TheRealNightmare/PlayerKoi/docs/gifs/king.gif

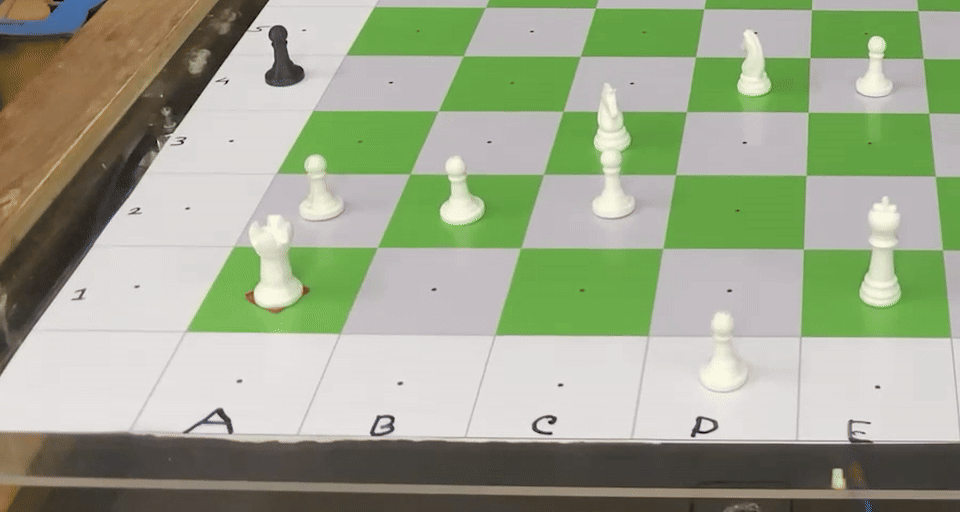
docs/gifs/king.gif
