TheRealNightmare/PlayerKoi/docs/gifs/queen.gif

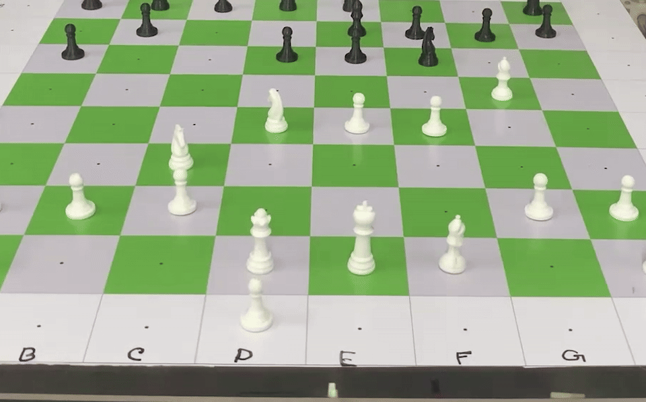
docs/gifs/queen.gif
