TheRealNightmare/PlayerKoi/RUNBOOK.md

# Runbook

Copy-pasteable command sequences for everything you actually do. Every command
here is executable as written — no placeholders to substitute.

- Whole cycle explained start to finish → [WORKFLOW.md](WORKFLOW.md)
- *Why* it works this way → [README.md](README.md) and [training/NOTES.md](training/NOTES.md)

## What do you want to do?

| | Section |
|---|---|
| Move data or models between the Pi and the PC | [A](#a-moving-files-between-the-machines) |
| Train a model — fresh, or improve the existing one | [B](#b-training) |
| Collect data for a new room / board / lighting | [C](#c-collect-data-for-an-environment) |
| Use crops collected automatically while playing | [D](#d-harvest-from-play) |
| Put a trained model on the Pi | [E](#e-export-and-deploy) |
| Play against the engine | [F](#f-playing-against-the-engine) |
| Play against the robot arm | [G](#g-playing-with-the-robot-arm) |
| Reprint the board sticker, or re-cut the panel | [J](#j-the-board-itself) |
| Watch the machine play itself | [G2](#g2-ai-vs-ai-no-camera) |
| Just start it and pick a mode | [G0](#g0-the-player-koi-menu) |
| Something broke | [H](#h-gotchas-that-have-actually-bitten) · [I](#i-tuning-knobs) |

## Machines

| | Path | venv |
|---|---|---|
| **Pi** (`nightmare@192.168.0.106`) | `~/C/PlayerKoi` | `.venv` |
| **Training PC** | `~/MicroChess` | `.venv-train` |

```bash
# Pi
ssh nightmare@192.168.0.106
cd ~/C/PlayerKoi && source .venv/bin/activate

# Training PC
cd ~/MicroChess && source .venv-train/bin/activate
```

The camera is on the Pi, so **all data is collected there**. The GPU is on the
PC, so **all training happens there**. Section A is how things cross.

## How the scripts find your model

`export_ncnn.py`, `eval_by_env.py` and `deploy.py` all resolve weights the
same way, so you normally pass **no path at all**:

```bash
ls runs/classify/*/weights/best.pt     # what you actually have
```

- **No flag** → the newest run under `runs/classify/`, printed for you to
  confirm. Add `--yes` to skip the prompt (needed in scripts — without a
  terminal it refuses rather than hanging).
- **`--run NAME`** → a specific run, e.g. `--run train-2`. Use this to go back
  to an older model.
- **A full path** (`--weights ...` / `--model-dir ...`) → always wins.

Ultralytics auto-increments run names (`train` → `train-2` → `train-3`), which
is why nothing below hardcodes one. Pass a path that doesn't exist and the
error lists the runs you really have.

> ⚠️ `runs/`, `training/datasets/` and `*.pt` are **git-ignored**. A trained
> `best.pt` exists in exactly one place — this machine's disk. Clearing
> `runs/` destroys it permanently; NCNN on the Pi cannot be converted back.
> The dataset is what's truly irreplaceable, so keep it on both boxes.

---

## A. Moving files between the machines

Everything moves by `rsync` over ssh. **Trailing slashes on both sides are
required** — they mean "the contents of", and without them you get a nested
directory. `rsync` **merges** into the destination; it never wipes what's
already there.

| What | Direction | When |
|---|---|---|
| `training/datasets/squares/` | Pi → PC | after collecting ([C](#c-collect-data-for-an-environment)) |
| `training/datasets/harvested/` | Pi → PC | after playing with `--harvest` ([D](#d-harvest-from-play)) |
| NCNN model directory | PC → Pi | after training ([E](#e-export-and-deploy)) |
| `config/calibration-env*.json` | **stays on the Pi** | never moves — it describes that Pi's camera |

### Pull the dataset (Pi → PC)

```bash
# on the training PC
rsync -av nightmare@192.168.0.106:~/C/PlayerKoi/training/datasets/squares/ \
          training/datasets/squares/
```

Verify it arrived before training on it:

```bash
find training/datasets/squares -name "*.jpg" \
  | sed 's#.*/\([^/]*\)/[^/]*$#\1#' | sort | uniq -c

tail -1 training/datasets/squares/manifest.jsonl
```

### Pull harvested crops (Pi → PC)

```bash
rsync -av nightmare@192.168.0.106:~/C/PlayerKoi/training/datasets/harvested/ \
          training/datasets/harvested/
```

Keep this **separate** from `squares/` until you've inspected it — see
[section D](#d-harvest-from-play).

### Push the model (PC → Pi)

Covered in full by [section E](#e-export-and-deploy) — `deploy.py` wraps the
`scp`, and the old model must be deleted first.

### Move everything at once

After a collecting session, before a training session:

```bash
# PC: pull both datasets
rsync -av nightmare@192.168.0.106:~/C/PlayerKoi/training/datasets/squares/ \
          training/datasets/squares/
rsync -av nightmare@192.168.0.106:~/C/PlayerKoi/training/datasets/harvested/ \
          training/datasets/harvested/
```

Going the other way — a fresh Pi, or one whose dataset you cleared — push the
dataset back so both machines hold a copy:

```bash
rsync -av training/datasets/squares/ \
          nightmare@192.168.0.106:~/C/PlayerKoi/training/datasets/squares/
```

Add `--dry-run` to any of these to see what would transfer without doing it.

---

## B. Training

**Nothing here ever trains from scratch.** Both modes below start from a
pretrained model — the only question is *which* pretrained model:

| Mode | Starts from | Use when |
|---|---|---|
| **Fresh** | `yolov8n-cls.pt` (ImageNet) | no previous run on this machine; or the current model went bad and you want a clean slate |
| **Continue** | your own `best.pt` | you added data and want to keep what the model already learned |

### Fresh — start from the pretrained YOLOv8n-cls

```bash
python training/train_classifier.py --data training/datasets/squares
```

That's the whole command. `--model` defaults to `yolov8n-cls.pt`, which
ultralytics downloads automatically if it isn't in the repo root.

Use this when `ls runs/classify/*/weights/best.pt` comes back empty, or when
you want to rule out a bad previous model. It costs ~30 s on the GPU for a
12-round dataset, so a clean rerun is cheap.

### Continue — fine-tune your current best

```bash
python training/train_classifier.py --data training/datasets/squares \
    --model runs/classify/train/weights/best.pt
```

This is the normal path after adding an environment or merging harvested
crops: it keeps everything the model learned about your *other* environments
instead of relearning them. Point `--model` at a path that exists — unlike the
other scripts, this flag is not auto-resolved, and a wrong path is an error
rather than a fallback.

### Resume an interrupted run

```bash
python training/train_classifier.py --resume --name train
```

Picks up from `runs/classify/<name>/weights/last.pt`. Only works once the run
has saved at least one epoch; data/epochs/imgsz come from the checkpoint, so
don't re-pass them.

### Flags worth knowing

| Flag | Default | Why you'd change it |
|---|---|---|
| `--epochs` | 50 | More rarely helps — collect data instead |
| `--imgsz` | 64 | **Keep in sync with `src/square_classifier.py`** |
| `--batch` | -1 (auto) | Auto-sizes to VRAM |
| `--device` | 0 | `cpu` to force CPU |
| `--name` | train | Label a run: `--name env3-test` |
| `--workers` | 8 | Lower to 2 or 0 on WSL2 |
| `--allow-cpu` | off | Otherwise it aborts rather than crawling on CPU |

### Reading the result

```
                   all      0.984          1     <- val top-1, per epoch
Test top-1: 0.9648   top-5: 1.0000              <- the honest number
Done. Best weights: .../runs/classify/train/weights/best.pt
```

**Trust the test number.** `best.pt` is chosen by whichever epoch scored best
on `val/`, so val has been peeked at. Then break it down per environment:

```bash
python training/eval_by_env.py --data training/datasets/squares
```

A weak row means collect more rounds *in that environment*. An old row that
dropped means the model is trading environments against each other — that one
needs more rounds too.

Then [export and deploy](#e-export-and-deploy).

---

## C. Collect data for an environment

An **environment** is one combination of room, lighting, camera height, board
and piece set. The classifier sees the board surface as background, so a
different board is a different problem — and so is a big lighting or
camera-position change. Run this section once per environment, with a new
`--env` tag each time.

**0. Probe first — does it even need training?**

Don't spend 25 rounds on a hunch. Calibrate, then point the *current* model at
the new setup and look at the grid:

```bash
# on the Pi
python3 src/calibrate.py --env 3
python3 src/debug_classifier.py --calibration config/calibration-env3.json
```

Any square showing the **wrong colour**, or more than ~15 of 64 below
min-conf, means train for it. If it looks clean, get a real number from 4
throwaway rounds:

```bash
# Pi
python3 src/collect_square_crops.py --env 3 --rounds 4 \
    --out training/datasets/probe-env3 --notes "PROBE"

# training PC
rsync -av nightmare@192.168.0.106:~/C/PlayerKoi/training/datasets/probe-env3/ \
          training/datasets/probe-env3/
python training/eval_by_env.py --data training/datasets/probe-env3 --split train
```

≥99% → no training needed, just play. 97–99% → 10–12 rounds. <97% → the full
25–30. Full procedure and how to read the confusions:
[WORKFLOW.md § 9](WORKFLOW.md#9-testing-a-new-environment-before-training).

If you do train, fold the probe in rather than recollecting it — it's already
labelled and already tagged `env3-`:

```bash
rsync -av training/datasets/probe-env3/ training/datasets/squares/
rm -rf training/datasets/probe-env3
```

**1. Collect** (on the Pi) — set the board up physically first

```bash
python3 src/collect_square_crops.py --env 3 --rounds 20 \
    --notes "spare room, ceiling light, glass set"
```

The env prefix keeps this run from overwriting earlier ones, so it **adds** to
the dataset. It prints existing counts on startup — confirm it's growing — and
appends a line to `training/datasets/squares/manifest.jsonl`.

Rounds are split whole into `train/` / `val/` / `test/`; never re-split these
by file, or burst frames leak across splits and the accuracy becomes a lie.

Collection doesn't use the model at all, only calibration, so it's fine that
the current model is useless in the new environment.

How much: **12 rounds** is the minimum (~97–98%, frequent corrections),
**25–30** is the target (~99%+). Split across sittings — 15 in daylight plus
15 under lamplight beats 30 in one go. The maths:
[WORKFLOW.md § 3c](WORKFLOW.md#3c-how-much-data-do-i-need).

**2. Move it to the PC** — [section A](#a-moving-files-between-the-machines).

**3. Train** — [section B](#b-training), *continue* mode if you already have a
model, *fresh* if you don't.

**4. Deploy** — [section E](#e-export-and-deploy).

> More rounds mainly buys **per-square coverage** (~10 of 64 squares get a
> piece per round). But 30 rounds in one sitting is one lighting condition —
> 15 now and 15 this evening is worth more.

---

## D. Harvest from play

`web_ui.py --harvest` saves labelled crops for all 64 squares every time a
move resolves — the tracker knows the true board state at that moment, so the
labels come free. It only writes crops; **nothing improves until you merge and
retrain.**

**1. Pull the crops** — [section A](#a-moving-files-between-the-machines)

```bash
rsync -av nightmare@192.168.0.106:~/C/PlayerKoi/training/datasets/harvested/ \
          training/datasets/harvested/
```

**2. Inspect before trusting it**

```bash
find training/datasets/harvested -name "*.jpg" \
  | sed 's#.*/\([^/]*\)/[^/]*$#\1#' | sort | uniq -c

ls training/datasets/harvested/train/black | head
```

These labels came from the tracker, not from you. If it was misreading a
square, merging teaches it its own mistake. Harvest is also excluded on undo,
deliberately — an undo reports the reverted position while the physical board
still shows the post-move one.

**3. Back up, then merge**

```bash
cp -r training/datasets/squares training/datasets/squares.bak
rsync -av training/datasets/harvested/ training/datasets/squares/
```

**4. Fine-tune** — *continue* mode, [section B](#b-training)

```bash
python training/train_classifier.py --data training/datasets/squares \
    --model runs/classify/train/weights/best.pt
```

**5. Check it didn't get worse**

```bash
python training/eval_by_env.py --data training/datasets/squares
```

**6. Export and deploy** — [section E](#e-export-and-deploy).

**7. If accuracy dropped**, the harvested labels were noisy:

```bash
rm -rf training/datasets/squares
mv training/datasets/squares.bak training/datasets/squares
# then redeploy the previous model with --run <older run>
```

Once a batch is merged and working, clear the Pi's copy so the next pull only
brings new material:

```bash
ssh nightmare@192.168.0.106 'rm -rf ~/C/PlayerKoi/training/datasets/harvested'
```

---

## E. Export and deploy

```bash
python training/export_ncnn.py --imgsz 64

mv runs/classify/train/weights/best_ncnn_model \
   runs/classify/train/weights/square_classifier_ncnn_model

# delete the old model FIRST — see gotchas
ssh nightmare@192.168.0.106 'rm -rf ~/C/PlayerKoi/models/square_classifier_ncnn_model'

python training/deploy.py nightmare@192.168.0.106 --dest ~/C/PlayerKoi/models/
```

Both scripts default to the newest run; add `--run train-2` to ship an older
one (that's also how you roll back). The `mv` gives the directory the name
`src/main.py`, `web_ui.py` and `debug_classifier.py` all expect.

Then on the Pi:

```bash
python3 src/debug_classifier.py      # verify before trusting it
python3 src/web_ui.py --harvest
```

Open `http://192.168.0.106:8000/`.

---

## F. Playing against the engine

```bash
sudo apt install stockfish           # one-time, on the Pi
python3 src/web_ui.py --harvest
```

Toggle the engine on in the box at the bottom, set the skill slider low to
start. Play your White move physically; the box shows Black's reply
(`d7 → d5`) with both squares highlighted, spelling out the extra action
for castling / en passant / promotion.

While a move is pending it's the **only** move the tracker accepts. Undo
and Edit board override that if you want to deviate.

---

## G0. The Player Koi menu

One launch, and you choose the mode in the browser:

```bash
python3 src/web_ui.py --robot /dev/ttyACM0        # or 'auto', or 'mock'
```

Park the carriage on **a8** first — it homes on startup. Then open
`http://<this-pi>:8000/` and pick a card:

| Card | What it is |
|---|---|
| **AI vs AI** | Section [G2](#g2-ai-vs-ai-no-camera) — no camera needed |
| **Play the engine** | Section [G](#g-playing-with-the-robot-arm) — needs calibration and a model |

A mode you can't run is greyed out with the reason and the script that fixes
it, so a fresh Pi with no model still gets you into AI vs AI.

The menu also sets skill, think time, move delay and the beginner style before
you start; the command-line flags become the menu's starting values.

**Back to menu** ends the mode and **parks the carriage at the origin**. The
game is discarded — re-entering a mode always starts from scratch, which
matches having to reset the pieces by hand.

**Reset** (on both screens) starts a new game *and* parks. It asks first,
because the carriage crosses the whole board to get there and will shove
anything standing in its way. On the menu it parks and nothing more.

The gantry's serial port is opened **once**, for the life of the process —
reopening it resets the Uno and loses the position — so switching modes never
costs you a re-park or a re-home.

The old direct commands still work and skip the menu:

```bash
python3 src/web_ui.py --ai-vs-ai --robot auto     # straight into AI vs AI
```

---

## G. Playing with the robot arm

Full circuit and first-time bring-up: **[docs/HARDWARE.md](docs/HARDWARE.md)**.
This section is the day-to-day sequence once it's built and calibrated.

**1. Power up in this order** — USB first, barrel jack second, with the
carriage hand-parked in the corner of travel beyond **h1** (White's right-hand
corner).

```bash
ls /dev/ttyACM*                      # confirm the Uno enumerated
```

That corner is the firmware's origin (0, 0), and since the r5 re-measurement the
firmware's square names are the real squares, so `rig.ORIGIN_SQUARE = "h1"`
sends them unrotated — `GOTO a1` from the web app and from the serial monitor
land on the same square. If the board is ever re-seated and the arm reaches for
the wrong squares, try the other corners with `--board-origin`.

The carriage has to be in that corner **every time the web app starts**, not
just at power-up: opening the serial port resets the Arduino, and it takes
wherever the carriage is standing as (0, 0). Left mid-board after a serial
monitor session, every move is offset and the edge squares run off the frame.

**2. First time on a rebuilt/re-flashed rig,** verify the geometry and the
clearance before anything touches a real game — `GOTO 7 0` must travel exactly
350 mm, and a knight must leave the back rank without catching the pawns
either side. Both procedures are in
[docs/HARDWARE.md](docs/HARDWARE.md#bring-up-and-calibration), steps 4 and 7.

Also check the arm can reach past the board edge, which is new with the V2
frame and is what captures depend on:

```
MM -415 10         # the slot past a1        → OK MM, not ERR out of range
MM -465 60         # the slot past the a-file
MM -15 410         # the slot past the h-file
BURY e2 -365 10    # carry a real pawn off — watch the set-down, not the drive
```

An `ERR out of range` here means the board is flashed with V1's travel limits.
A piece that is *towed* as the carriage leaves means the settle pause is too
short (`DWELL`); an ordinary move sets down the same way, so fix it here.

**On a frame that has never moved before**, do the walker instead of the four
commands above — it covers the same ground exhaustively and with the magnet
dead, so nothing can be dragged while you find out the frame is wrong. Flash
`firmware/chessbot_walker/chessbot_walker.ino`, open the serial monitor at
115200, press `5` to prove the travel limits, `1` for the four corners, then `3` for the graveyard ring, then
`2` for all 64 squares. Each stop should land on its printed dot.
**Re-flash `chessbot_v1.ino` before connecting the Pi** — a board left with
the walker on it looks like a dead serial link.
See [docs/CONNECTION.md](docs/CONNECTION.md) for the full key list.

**3. Dry run if anything changed** (firmware, wiring, the code):

```bash
python3 src/web_ui.py --robot mock   # logs every gantry command, moves nothing
```

**4. Then for real.** It homes on startup — keep hands clear.

```bash
python3 src/web_ui.py --robot /dev/ttyACM0 --harvest
```

Toggle the engine on as usual. From then on it plays its own moves: you move
White, the arm answers.

**When it captures**, it carries the piece off the board itself: the victim
is lifted first, driven to the nearest free slot in the 50mm margin around
the board, and set down there. Nothing is asked of you. The 32 slots are
shared between both colours, so the pile is not a scoreboard — the arm takes
whichever is nearest, to keep the trip short.

The only time a capture stops is if all 32 slots are full, which cannot
happen in a legal game (30 pieces can be captured) but can if a hand-built
position and a stale pile disagree. Then it falls back to asking you to lift
the piece, as it always used to.

**When it promotes**, the UI asks you to swap a queen in. Do it; the software
already thinks it's a queen.

**If it halts** (red box), the camera didn't agree with what the arm did.
Fix the physical board with **Edit board** or **Undo last move**, then press
**Home / re-enable**. It will not move again until you do.

**Every piece is held by attract**, white and black alike — their magnets are
all fitted the same way up. Each carry is: coil off, drive to the piece, coil
on + grip pause (1000 ms), carry at constant speed, coil off + a short weak
reverse pulse that clears the core + settle pause (1000 ms).
The castling rook goes around the **outside** of the board — half a square
past the back rank, between the board and the graveyard strip — so it never
passes the king or the pawns. After a captured piece is set down in the
graveyard, the arm waits an extra second before going back for the capturer.
Knight L-moves, the castling rook and graveyard trips run at the
**Gridline power** set in the Robot arm panel (100% by default, `GRID <pct>`
in the bench console). Lower it if neighbouring pieces get dragged along; it
saves itself and is reapplied on every start.

**If the arm pushes pieces away instead of picking them up**, the magnets are
the other way up. Switch **Pieces held by** to *repel* in the Robot arm panel
(or `POL 1` in the bench console). It applies to every piece, is saved to
`config/rig.json`, and is reapplied on every start.

**If a piece slides toward the carriage before it arrives**, the core is
still magnetised from the last move. Raise **Clear pulse strength** (or
time) in the Robot arm panel. If a piece that was just set down gets pushed
instead, lower it.

**If a piece is towed along after it is set down**, the core is still
magnetised when the carriage leaves. Raise **Settle pause** in the Robot arm
panel; it saves itself to `config/rig.json`. **If a piece is left behind at
the start of a drag**, raise **Grip pause** instead.

**If the UI says the firmware is out of date**, re-upload
`firmware/chessbot_v1/chessbot_v1.ino`. The arm refuses to move until you do,
and that is deliberate: a board older than r7 still holds white pieces by
repel, so every white move would shove a piece off its square, and an r9
board has no `CASTLE`. Check with the startup line — it should say
`firmware r10`.

**Bench console** for poking the gantry directly, without any chess:

```bash
python3 src/robot.py --port /dev/ttyACM0 --console
gantry> HOME
gantry> GOTO 3.5 4
gantry> POL 1           # hold every piece by repel (0 = attract, the default)
gantry> DWELL 1000 1000 # grip pause / settle pause, ms
gantry> KICK 110 20     # clearing pulse after a set-down: duty, ms (0 0 = off)
gantry> GRID 100        # gridline magnet power, % (knights, castling, graveyard)
gantry> MAG 170
gantry> OFF
```

---

## G2. AI vs AI (no camera)

Stockfish plays both sides and the arm places every move. **Nothing in this
mode uses the camera** — no calibration, no classifier, no model. The position
is tracked purely in software (`src/headless_loop.py`), which is sound only
because the arm is the sole thing touching the board.

That is the trade: there is no verification. A slipped belt, a dragged
neighbour, a piece knocked over — none of it is detected, and every move after
it is played into a position that no longer exists.

**1. Set the board up completely.** All 32 pieces, standard position, White at
the a1 end. This is assumed, never checked.

**2. Park the carriage in the corner beyond h1** by hand. No limit switches —
`HOME` drives to the assumed origin rather than finding it.

**3. Dry run first** if anything changed:

```bash
python3 src/web_ui.py --ai-vs-ai --robot mock
```

**4. Then for real.** It homes on startup — keep hands clear.

```bash
python3 src/web_ui.py --ai-vs-ai --robot /dev/ttyACM0 \
    --engine-skill 3 --move-delay 2
```

Open the UI and press **play**. `--move-delay` is the pause between moves;
keep it generous the first few games so you have time to reach **HALT**.

**It plays like a beginner on purpose.** Pawn moves are preferred, and it will
only move a knight or castle when nothing else is legal — those are the two
moves that make the arm weave along the gridlines at reduced magnet duty, which
is where pieces get dropped. Over a full game that takes knight weaves from
roughly 15% of moves to zero. Pass `--no-noob` to play normally. It costs two
engine searches per move, so budget ~2x `--engine-think`.

**Captures no longer stop for you** — the arm parks the piece on a graveyard
slot and carries straight on. See section G.

**Promotions are advisory**: swap a queen in when asked. The software already
records it as a queen either way, so the arm will keep dragging the pawn
around as one if you don't.

**Watch the first few moves.** Once the physical board and the software
diverge, nothing will tell you — that's what the camera was for.

---

## H. Gotchas that have actually bitten

**Run directory is `train-2`, not `train2`.** Ultralytics auto-increments
with a hyphen. You rarely need to type it — the scripts default to the newest
run — but `--run` and `train_classifier.py --model` both want the real name.

**`scp -r` nests into an existing directory.** If
`models/square_classifier_ncnn_model` already exists on the Pi, deploying
creates `square_classifier_ncnn_model/square_classifier_ncnn_model` and
the model fails to load. Always `rm -rf` the old one first.

**Collect with `--env`.** Filenames are prefixed with the env tag, which is
what makes a batch traceable, removable, and scoreable by
`eval_by_env.py`. Without it the crops still land safely (the session id
defaults to a timestamp, so nothing collides) but they show up forever as
`untagged` and can't be attributed to a setup.

**`--harvest` never fixes anything by itself.** It only writes crops. You
have to merge and retrain.

**`runs/` is git-ignored, and clearing it is irreversible.** A `best.pt`
lives only on the training PC's disk; the Pi has an NCNN export, which
cannot be converted back to `.pt`. This has already cost one trained model.
The dataset matters more than the weights — weights can be retrained in
seconds, 30 rounds of collection cannot.

**Fine-tuning needs weights that exist.** `--model runs/classify/.../best.pt`
fails on a machine where `runs/` is empty. Omit `--model` and it correctly
starts from the pretrained `yolov8n-cls.pt`.

**Trust test top-1, not val.** `best.pt` is chosen by whichever epoch scored
best on `val/`, so val has effectively been peeked at. A large val-test gap
means the model memorised the training rounds — collect more, don't train
longer.

---

## I. Tuning knobs

| Problem | Knob |
|---|---|
| Moves not detected at all | `web_ui.py --motion-thresh 2.0` (default 3.0). Diagnose with `debug_classifier.py --watch` |
| Too many "low-confidence" flags | `web_ui.py --min-conf 0.4` (default 0.5) |
| Wrong moves accepted | Raise `--min-conf`, or collect more data for the squares that misread |
| Engine too strong | Skill slider in the UI (0–20; 0 is genuinely beatable) |
| Board diagram wrong | **Undo last move** for one bad move; **Edit board** for a full resync |
| Arm drops pieces mid-drag | Raise `MAG_HOLD`/`MAG_EDGE` in `src/robot_moves.py` (the firmware clamps at `MAG_MAX_PWM`) |
| **Neighbouring pieces dragged along as the arm passes** | Lower `MAG_EDGE`. This was the V1 board's defining problem; on 50 mm squares the magnet's edge stops 12.5 mm short of a flanking piece's centre, so if it still happens suspect the coil or the piece bases rather than the routing — see Clearances in [docs/HARDWARE.md](docs/HARDWARE.md) |
| **A piece is towed after it is set down** | Raise the settle pause (`DWELL`, or the Settle slider) — `BURY` sets down the same way a move does, so tuning it fixes both |
| **`ERR out of range` on a capture** | The board is flashed with travel limits that stop at the board edge. Re-upload `chessbot_v1.ino`; V2 needs x `-480..0`, y `0..470` (banner `r10`) |
| **The arm skips slots that are visibly empty** | The saved pile in `config/rig.json` is stale. Reset the game from the menu, which clears it |
| **Knight catches pieces leaving the back rank** | The opening pawn wall is the one case routing can't improve on — but on 50 mm squares that is still 25 mm each side, so this should no longer happen. If it does, the coil is too strong or reaching too far: lower `MAG_EDGE` |
| Magnet coil getting hot | Lower `MAG_MAX_PWM` in the sketch, or feed the DRV8872 from a 5 V buck |
| Pieces land off-centre | Tune `PULSE_REVERSE_MS`/`PULSE_HOLD_MS` in the sketch |
| Piece knocked off the board when toppled | Only the dormant native planner topples; the live one carries captures off. Lower `TOPPLE_MS` in `chess_gantry` if you are running that |
| Arm drifts a bit further off every move | `STEPS_PER_SQUARE` should be exactly 1000 — verify `GOTO 7 0` travels 350 mm. If it does, the motors are stalling: lower `MAX_SPEED` |
| Arm too slow | `MAX_SPEED` 1500 → 2500 steps/s (75 → 125 mm/s), once the belts are tensioned |
| Motors buzz but don't turn | `MAX_SPEED` too high to start from rest (no acceleration in `MultiStepper`), or Vref too low |
| An axis homes away from its switch | Swap one coil pair on that motor — no code change |
| Not enough time to clear a captured piece | No longer applies — the arm parks captures itself. `--topple-delay` only affects the dormant native planner |
| Arm halts constantly | The camera is disagreeing with it — check `debug_classifier.py` before blaming the gantry |
| **The Uno enumerates but answers nothing** | It may still have the bring-up walker flashed. Re-upload `firmware/chessbot_v1/chessbot_v1.ino` |

Diagnostics:

```bash
python3 src/debug_classifier.py            # per-square class + confidence
python3 src/debug_classifier.py --watch    # live motion-gate scores
```

## J. The board itself

The printed sticker and the laser-cut panel are **generated**, not drawn by
hand. Regenerate rather than editing the files in `design/`:

```bash
python3 tools/make_sticker.py                 # design/chessboard_400mm_sq50mm.pdf
python3 tools/make_board.py                   # design/ChessBot_V2_board.{dxf,ai,svg,step}
python3 tools/make_board.py --thickness 6     # ...for 6 mm MDF instead of 5 mm acrylic
```

No dependencies beyond the standard library, so these run anywhere — the
repo's `.venv-train` is not needed and is in fact broken (its `pyvenv.cfg`
points at a `site-packages` under a path it no longer lives at).

**Printing the sticker.** 570 mm is wider than A3, so it needs a wide-format
or plotter print at **100% scale — "actual size", never "fit to page"**. The
sheet carries a 100 mm ruler along the bottom for exactly this: measure it
before sticking anything down. A sticker printed at 97% puts every square's
dot progressively further from where the machine believes it is, and the
error is worst at the far corners where you will notice it last.

The dots are not decoration — they are what `src/calibrate.py` asks you to
click, and what every `GOTO` addresses. There is one per square and one per
graveyard slot.

**Changing the square size** re-cuts everything downstream, so it is a
deliberate act:

```bash
python3 tools/make_sticker.py --square 28.75 --page 295 --no-graveyard   # the V1 board
```

Then `SQUARE_MM`, `A1_X_MM` and the travel limits have to change in
`firmware/chessbot_v1/chessbot_v1.ino` **and** `src/rig.py`, which mirrors it.
The firmware is the source of truth; if the two disagree, the firmware is
right and `rig.py` is stale. `tests/test_rig.py` and `tests/test_firmware_rev.py`
check the parts of that contract they can see from Python.

**The sticker colours are load-bearing.** The classifier was trained on crops
of that specific green and grey, so changing them means retraining — see
[training/NOTES.md](training/NOTES.md).
