TheRealNightmare/PlayerKoi/docs/gifs/bishop.gif

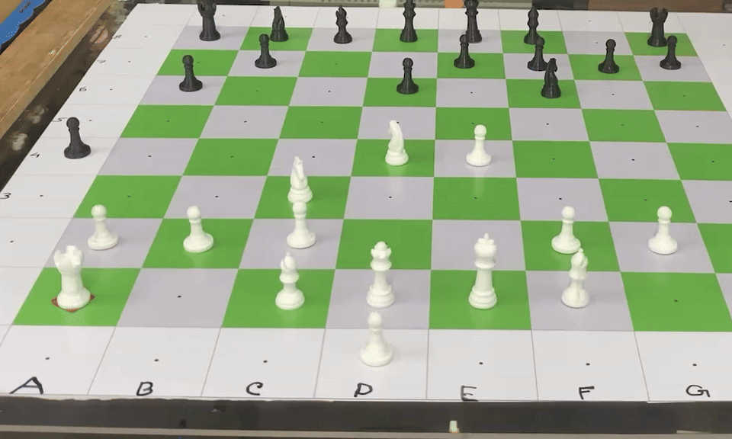
docs/gifs/bishop.gif
