TheRealNightmare/PlayerKoi/docs/gifs/capture.gif

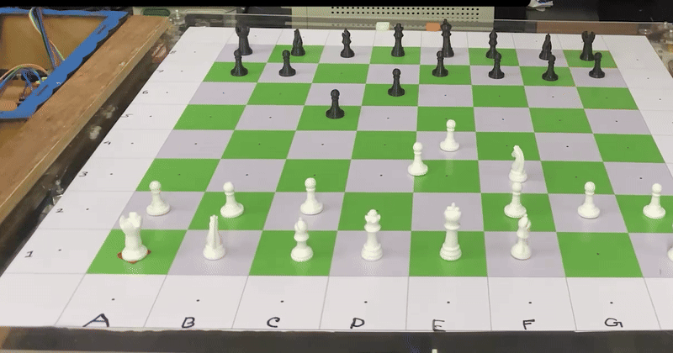
docs/gifs/capture.gif
