TheRealNightmare/PlayerKoi/docs/gifs/knight.gif

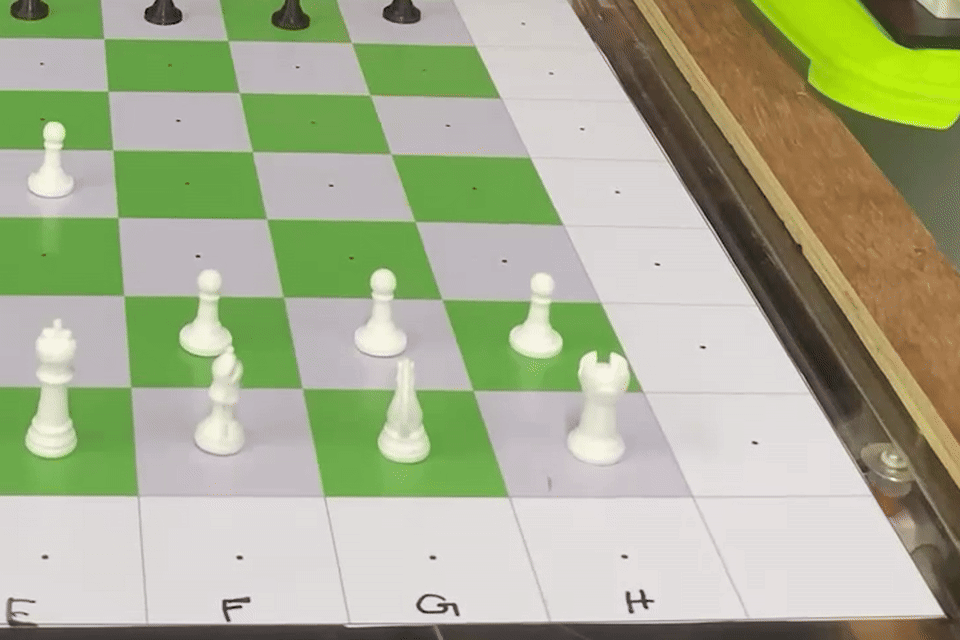
docs/gifs/knight.gif
