TheRealNightmare/PlayerKoi/docs/gifs/pawn.gif

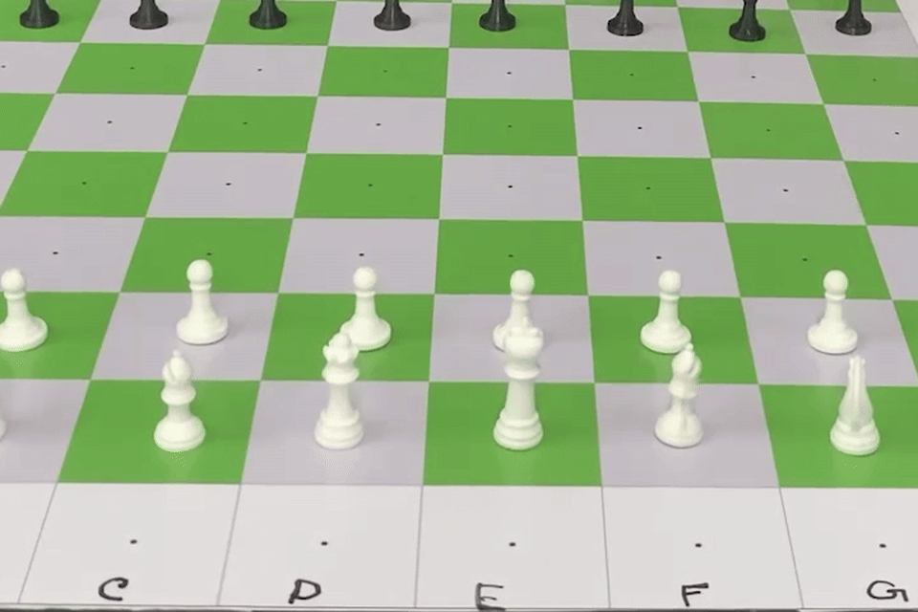
docs/gifs/pawn.gif
