TheRealNightmare/PlayerKoi/docs/gifs/rook.gif

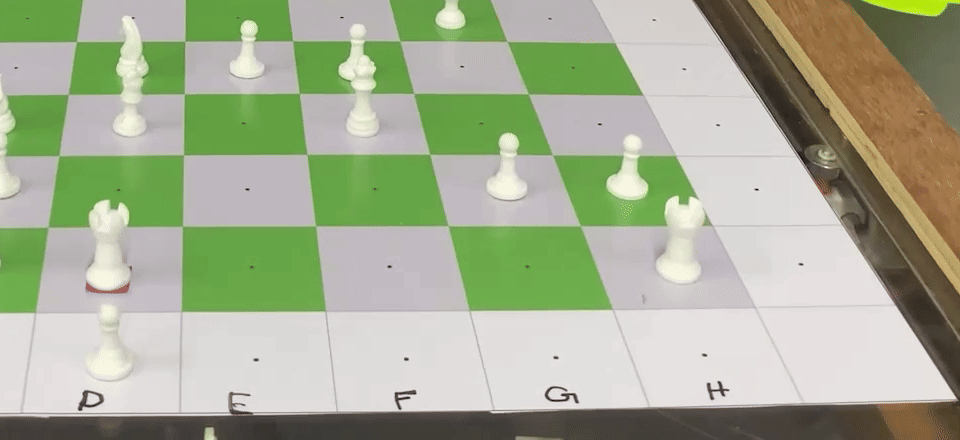
docs/gifs/rook.gif
