TheRealNightmare/PlayerKoi/video/poster.png

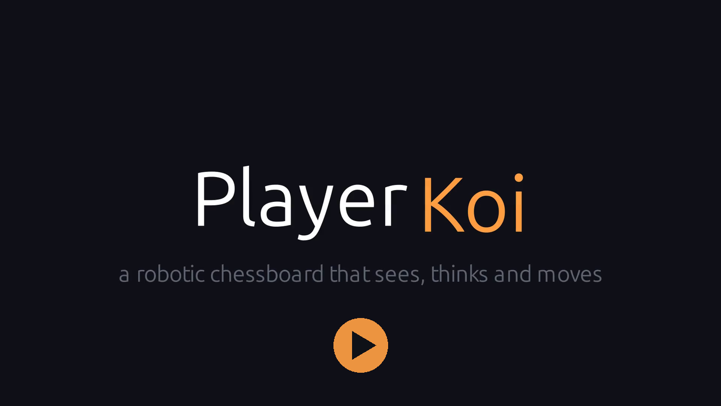
video/poster.png
