TheRealNightmare/PlayerKoi/design/ChessBot_V2_board.step

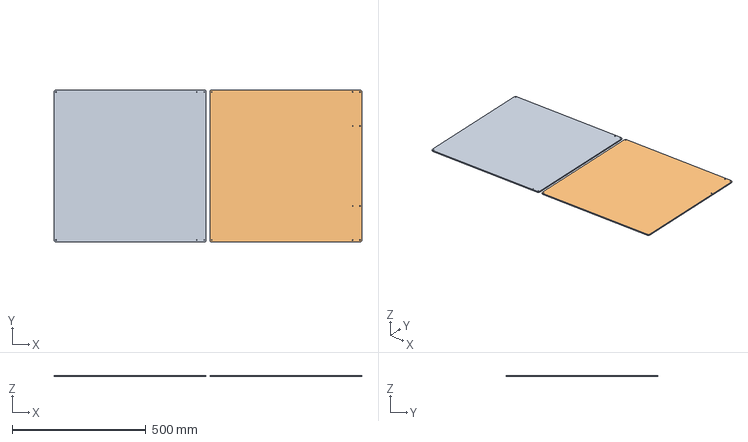
[picture p9: CAD file, 2026-09-21, last stored version]
design/ChessBot_V2_board.step
1153.6 x 570.0 x 5.00 mm
