TheRealNightmare/PlayerKoi/(list of files, cad)

Other CAD files:
design/ChessBot_V2_board.dxf
