TheRealNightmare/PlayerKoi/design/chessboard_400mm_sq50mm.pdf

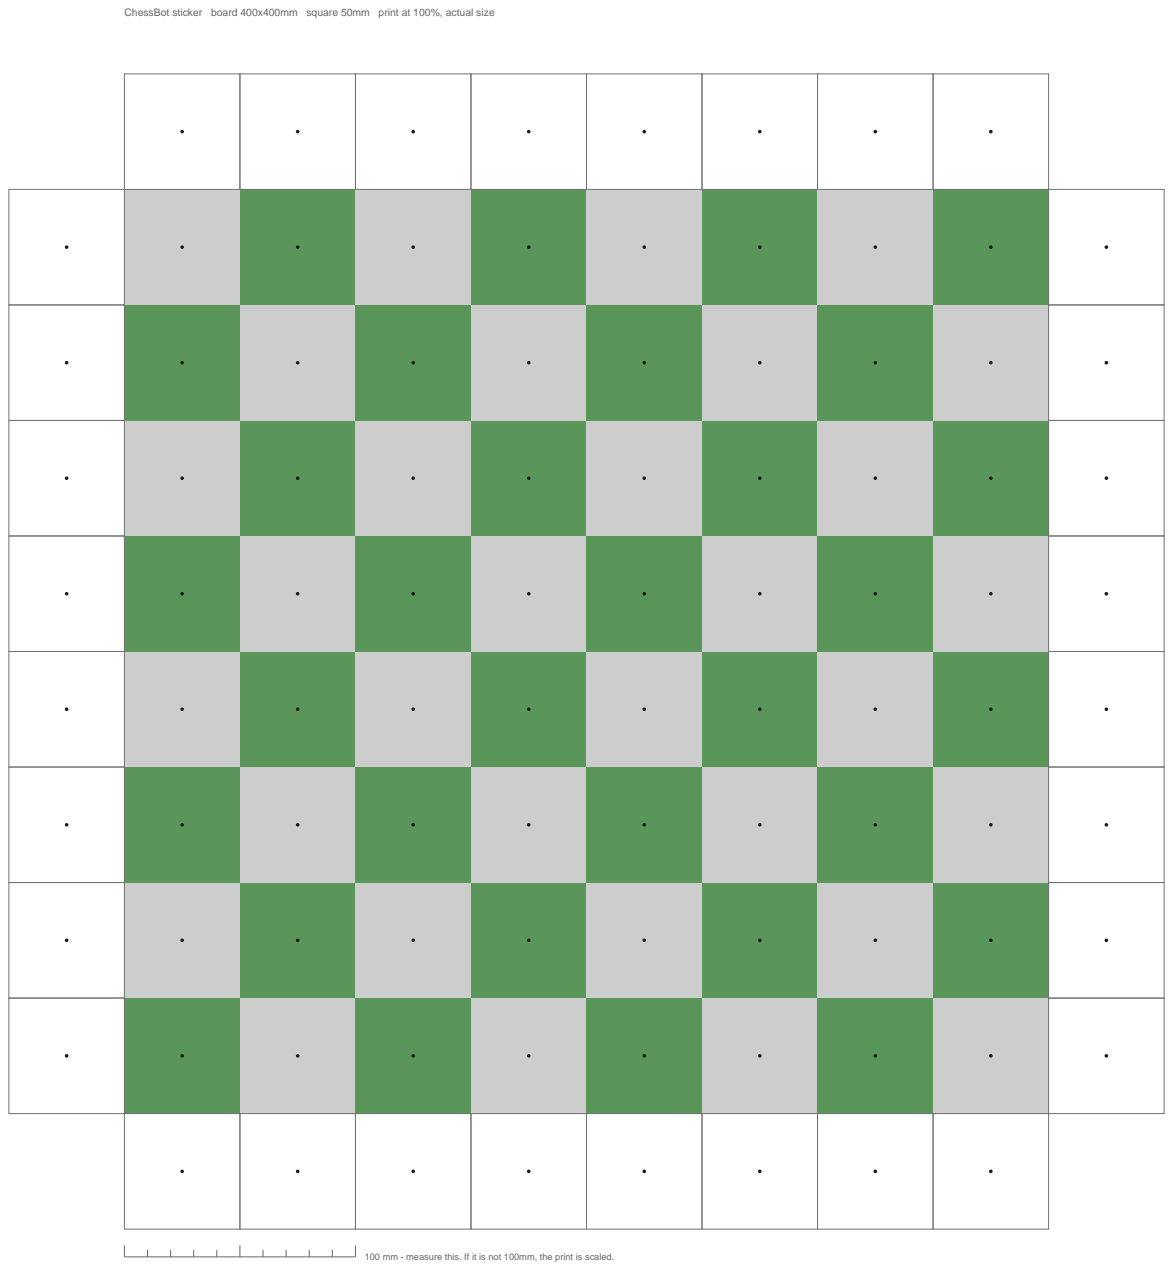
[picture p10: page 1]

ChessBot sticker board 400x400mm square 50mm print at 100%, actual size

100 mm - measure this. If it is not 100mm, the print is scaled.
