TheRealNightmare/PlayerKoi/src/rig.py

"""Measured constants for the physical machine.

Every number here was measured on the rig and is mirrored from
firmware/chessbot_v1/chessbot_v1.ino, which is the single source of truth.
This module exists so the Python side, the docs and the bench sheet can cite
one place instead of re-declaring geometry that then drifts apart.

If a value here disagrees with the firmware, the FIRMWARE is right and this
file is stale -- it is the thing that actually drives the motors.

A warning about the other numbers in this repo:

* RunChess/chess.txt has SQUARE_MM = 25.7 and a different a1 offset. That is
  an older calibration for the 200x200 frame, from before the belt slip was
  fixed by re-belting. It is superseded. Do not use it.
* firmware/chess_gantry/ declares its own constants (20 steps/mm, 75mm/s,
  MAG_MAX_PWM 170). Those belong to a different, unbuilt machine and are not
  this rig's -- see that sketch's header.

COORDINATES

Two systems meet here, so be explicit about which one is in play:

    file/rank   0..7 on each axis, a1 = (0, 0), h8 = (7, 7). What the chess
                code (robot_moves, move_resolver) speaks. Fractions are legal
                and mean the lattice line between two squares.
    machine mm  what the firmware speaks. The ORIGIN is the corner of travel
                beyond h1 (not a square centre, and not a1), and x runs
                NEGATIVE toward the a-file. So h1 is at (-65, 60) and a1 is
                at (-415, 60).

square_to_mm() converts. In legacy mode nothing on the Python side sends mm
at all -- the firmware takes square names and does its own arithmetic -- so
this conversion is for bench work and for the dormant native path.
"""

# Board geometry. V2: 400x400mm playing area on a 50mm pitch, BOTH axes -- the
# earlier 200mm Y span was belt slip and was fixed mechanically, so there is no
# separate Y pitch.
SQUARE_MM = 50.0
BOARD_MM = SQUARE_MM * 8        # 400, the playing area

# a1's centre in machine coordinates. The origin (0, 0) is the corner of
# travel beyond h1 -- as far toward the h-file and rank 1 as the carriage
# goes -- which is also the park position. So every square is at negative x
# and positive y: h1 is (-65, 60), a8 is (-415, 410).
A1_X_MM = -415.0
A1_Y_MM = 60.0

# Travel limits, MEASURED on the machine by jogging to the frame: 480 x 470mm,
# not the 500 x 500 the frame was drawn for. The graveyard ring's slot centres
# span 450mm each way, centred in that reach (15mm clear at each X limit, 10mm
# at each Y limit), and the board sits one square pitch inside the ring.
GRAVEYARD_DEPTH_MM = 50.0
MIN_X_MM, MAX_X_MM = -480.0, 0.0
MIN_Y_MM, MAX_Y_MM = 0.0, 470.0

# Where captured pieces go: a ring of parking slots in the 50mm margin, one
# strip on each of the four sides, eight slots per strip on the board's own
# file/rank centre lines. 32 in total, shared between both colours.
#
# The four 50x50mm corner cells are deliberately left empty. A corner slot
# would sit on no centre line at all, so its dot would not line up with the
# printed grid, and 32 already exceeds the 30 pieces that can ever be
# captured -- there is nothing to gain by squeezing in four more.
GRAVEYARD_Y_LOW_MM = A1_Y_MM - SQUARE_MM             # 10, beyond rank 1
GRAVEYARD_Y_HIGH_MM = A1_Y_MM + BOARD_MM             # 460, beyond rank 8
GRAVEYARD_X_LOW_MM = A1_X_MM - SQUARE_MM             # -465, beyond the a-file
GRAVEYARD_X_HIGH_MM = A1_X_MM + BOARD_MM             # -15, beyond the h-file

# Motion scale: 200 steps/rev at 1/2 microstepping over a 20-tooth GT2 pulley
# on 2mm belt = 400 steps per 40mm = 10 steps/mm. The microstepping jumpers
# matter: a CNC Shield defaults to 1/8, which would make every distance 4x
# too large. See docs/CONNECTION.md troubleshooting.
MICROSTEPS = 2
MOTOR_STEPS_PER_REV = 200.0
PULLEY_TEETH = 20.0
BELT_PITCH_MM = 2.0
MM_PER_REV = PULLEY_TEETH * BELT_PITCH_MM          # 40.0
STEPS_PER_MM = (MOTOR_STEPS_PER_REV * MICROSTEPS) / MM_PER_REV   # 10.0

# Feed rate, the proven 40mm/s. The firmware defaults to it and the host
# re-sends SPEED on every connect. The firmware accepts SPEED 1-100 mm/s.
FEED_MMS = 40.0

# Magnet duty, as a PWM count. FULL drags a piece square-to-square and is
# fixed; the gridline legs use grid_pct below. Mirrors the firmware --
# chess_gantry's 170 cap is for different hardware and does not apply.
MAG_FULL = 255

# Hand-tuned motion settings, each (default, min, max). All are runtime
# values on the board (DWELL, GRID, KICK), re-sent on every connect and adjustable
# from the web UI, because they are only judged by watching the arm:
#
#   grip_ms    coil on, carriage still, before a piece is dragged -- so it is
#              pulled flat onto the pole first. A full second: 150 ms let
#              knights slip off on the gridline run.
#   settle_ms  after the set-down and the clearing pulse, coil fully OFF,
#              before the carriage drives on. A piece still towed when the
#              carriage leaves means this is too short.
#   grid_pct   magnet power on every gridline leg (knights, the castling
#              rook, BURY), in percent of MAG_FULL. 60% and then 80% both
#              sometimes lost the piece partway along the L, hence full.
#   kick_duty  the clearing pulse after a set-down: a short, weak drive the
#   kick_ms    opposite way to the hold, to clear the leftover magnetism that
#              otherwise pulls the next piece toward the carriage before it
#              arrives. Too strong shoves the piece just set down. 0 = off.
MOTION_TUNING = {
    "grip_ms": (1000, 0, 2000),
    "settle_ms": (1000, 0, 2000),
    "grid_pct": (100, 0, 100),
    "kick_duty": (110, 0, 255),
    "kick_ms": (20, 0, 200),
}

# Every piece on this set has its magnet the same way up, so ONE polarity
# holds all of them, white and black alike. A carry is always: coil off,
# drive to the source, coil on + grip_ms, carry, coil off + settle_ms. The
# firmware owns that sequence (doMove/doKnight/doBury in chessbot_v1.ino);
# moves carry no colour.
#
# Which polarity that is: attract, as the set was magnetised. It is a runtime
# setting (POL, saved in config/rig.json, toggled in the web UI) in case the
# magnets turn out to be fitted the other way up. Mirrors HOLD_BY_REPEL in
# the sketch.
HOLD_BY_REPEL = False


# The square whose outer corner is the origin: where the carriage rests, and
# where a human must park it before HOME -- in the corner of travel beyond
# this square, not on its centre. There are no limit switches: HOME drives to
# the assumed origin rather than seeking anything, so if the carriage isn't
# actually in that corner when the board powers up, every coordinate that
# follows is silently wrong.
PARK_SQUARE = "h1"

BAUD = 115200
READY_BANNER = "READY ChessBot-V1"

# The protocol revision this code expects from the sketch. Bumped whenever the
# host starts relying on something a older board doesn't do.
#
#   r1  the original: no polarity suffix. It accepts "MOVE e2e4 w" anyway --
#       parsePly reads four characters and ignores the rest -- and silently
#       attracts for every move, which shoves every white piece off its
#       square. That silence is why this check exists.
#   r2  w|b suffix on MOVE/KNIGHT, plus POL and POLTEST.
#   r3  the faded release, plus RELEASE to tune it.
#   r4  BURY, for parking a captured piece on a graveyard slot. The first
#       command that drives to a raw machine coordinate in normal play, so an
#       r3 board cannot fake it -- it has no verb that reaches off the board.
#   r5  re-measured geometry: the origin moved from h1's centre to the corner
#       of travel beyond h1, and a1 to (-415, 60). No new verbs, but an r4
#       board takes the same square names and BURY coordinates and drives
#       somewhere else -- so it has to be refused just the same.
#   r6  DWELL (grip/settle pauses) and KICK (tunable de-cling), both sent on
#       connect, which an r5 board answers with ERR; BURY travels the
#       gridlines instead of a straight diagonal.
#   r7  every piece re-magnetised the same way up: the coil attracts all of
#       them. POL, POLTEST, RELEASE and KICK are gone, as is the w|b suffix on
#       MOVE/KNIGHT/BURY; a set-down is a plain coil-off plus the settle
#       pause. An r6 board would still hold white by repel and shove it off.
#   r8  GRID, the gridline magnet power, sent on connect -- an r7 board
#       answers ERR unknown GRID.
#   r9  KICK back: a weak reverse pulse after each set-down to clear the
#       core, sent on connect -- an r8 board answers ERR unknown KICK. Also a
#       1 s grip and settle, and constant speed (the r8 ramp is gone).
#   r10 CASTLE, the castling rook around the outside of the board, sent
#       mid-game -- an r9 board answers ERR unknown CASTLE with the king
#       already moved. Also an extra 1 s after BURY.
FIRMWARE_REV = 10

# After a captured piece is set down in the graveyard, the firmware waits
# this long on top of the settle pause. Mirrors BURY_WAIT_MS in the sketch.
BURY_WAIT_MS = 1000


def banner_rev(banner):
    """The revision from a READY line. A banner with no revision is r1 -- that
    is precisely what the original sketch prints."""
    for token in (banner or "").split():
        if token.startswith("r") and token[1:].isdigit():
            return int(token[1:])
    return 1


# ---------------------------------------------------------------- orientation
#
# The one value in this file that is NOT mirrored from the firmware, because
# the firmware has no concept of it: chessbot_v1 parses square names
# arithmetically (charAt(0) - 'a') and assumes the carriage parks beyond h1.
#
# Since the r5 re-measurement that assumption is TRUE on this machine: the
# origin, (0, 0), is the corner of travel beyond h1 -- White's right-hand
# corner -- and "GOTO a1" typed into the serial monitor lands on the real a1.
# So no correction is applied. (Before r5 the board was treated as seated
# 180 degrees round and this was "a8"; keeping that after the re-measurement
# rotated every square twice over, sending a1 past a8 into the graveyard.)
#
# The rotation is kept, and selectable with --board-origin, for a board that
# is ever re-seated. The four values are the real square the carriage parks
# beyond:
#
#     "h1"   what the firmware assumes -- no correction    <- this rig
#     "a8"   rotated 180 degrees: file AND rank flip
#     "h8"   ranks flip, files don't (a mirror, from a reversed Y axis)
#     "a1"   files flip, ranks don't
ORIGIN_SQUARE = "h1"

# (flip_file, flip_rank) for each supported origin.
_ORIENTATIONS = {
    "h1": (False, False),
    "a8": (True, True),
    "h8": (False, True),
    "a1": (True, False),
}

SUPPORTED_ORIGINS = tuple(_ORIENTATIONS)


def orient(file_, rank, origin=None):
    """(file, rank) as chess means it -> (file, rank) as the machine means it.

    Its own inverse for every supported origin, so a round trip is the
    identity and the helper can be used in either direction.
    """
    origin = ORIGIN_SQUARE if origin is None else origin
    try:
        flip_file, flip_rank = _ORIENTATIONS[origin]
    except KeyError:
        raise ValueError(
            f"unknown board origin {origin!r} -- expected one of {', '.join(_ORIENTATIONS)}"
        )
    return (7 - file_ if flip_file else file_, 7 - rank if flip_rank else rank)


def orient_square(name, origin=None):
    """"e2" -> "d7" with origin "a8"; unchanged at the default "h1". For
    square names bound for the firmware."""
    file_, rank = orient(ord(name[0]) - ord("a"), int(name[1]) - 1, origin)
    return f"{chr(ord('a') + file_)}{rank + 1}"


def orient_uci(uci, origin=None):
    """"e2e4" -> "d7d5". Only the four square characters -- a promotion
    suffix is dropped, since MOVE/KNIGHT take squares and the firmware has no
    idea what a promotion is."""
    return orient_square(uci[:2], origin) + orient_square(uci[2:4], origin)


def square_to_mm(file_, rank):
    """(file, rank) in 0..7 -> (x, y) in machine mm. Fractions are fine.

    Mirrors gotoSquareF() in the firmware.
    """
    return (A1_X_MM + file_ * SQUARE_MM, A1_Y_MM + rank * SQUARE_MM)


# The board's centre in board-space mm -- the point every orientation flip is
# symmetric about. a1 and h8 centres are 7 squares apart, so the middle is 3.5.
BOARD_CENTRE_X_MM = A1_X_MM + 3.5 * SQUARE_MM
BOARD_CENTRE_Y_MM = A1_Y_MM + 3.5 * SQUARE_MM


def orient_mm(x_mm, y_mm, origin=None):
    """Board-space mm -> machine mm, applying how the board is seated.

    The mm counterpart of orient(). It exists because orient() can only rotate
    file/rank indices, and a graveyard slot has neither -- it sits outside the
    8x8, so there is no index to flip. Reflecting the millimetres about the
    board centre does the same job and works for any point, on the board or
    off it.

    It is the identity at the default origin (h1). On a re-seated board it is
    NOT optional: with a 180 degree rotation, a slot handed to the firmware
    unmirrored lands on the diagonally opposite slot -- the arm drives a
    captured piece the full width of the board to the wrong place, and nothing
    reports it.

    Like orient(), it is its own inverse for every supported origin.
    """
    origin = ORIGIN_SQUARE if origin is None else origin
    try:
        flip_file, flip_rank = _ORIENTATIONS[origin]
    except KeyError:
        raise ValueError(
            f"unknown board origin {origin!r} -- expected one of {', '.join(_ORIENTATIONS)}"
        )
    if flip_file:
        x_mm = 2 * BOARD_CENTRE_X_MM - x_mm
    if flip_rank:
        y_mm = 2 * BOARD_CENTRE_Y_MM - y_mm
    return (x_mm, y_mm)


def within_travel(x_mm, y_mm):
    """Whether a machine coordinate is physically reachable."""
    return MIN_X_MM <= x_mm <= MAX_X_MM and MIN_Y_MM <= y_mm <= MAX_Y_MM


# The four strips, named for the board edge each sits beyond. Slots are
# numbered counter-clockwise from SOUTH's a-file end, 8 per strip:
#
#              NORTH  16..23  (right to left)
#           +-------------------+
#   WEST    |                   |   EAST
#   24..31  |      the 8x8      |   8..15
#   (top    |                   |   (bottom
#    down)  +-------------------+    up)
#              SOUTH  0..7  (left to right)
#
# Counter-clockwise rather than "all of one edge, then all of the next in
# reading order" so that consecutive indices are always physically adjacent,
# including across the corner joins. Anything that walks the ring -- filling
# it in order, finding the next free slot near a full one -- then gets
# adjacency for free instead of special-casing four seams.
SOUTH, EAST, NORTH, WEST = "south", "east", "north", "west"
GRAVEYARD_STRIPS = (SOUTH, EAST, NORTH, WEST)

SLOTS_PER_STRIP = 8
GRAVEYARD_SLOTS = SLOTS_PER_STRIP * len(GRAVEYARD_STRIPS)   # 32


def graveyard_strip(slot):
    """Which of the four strips a slot index falls on."""
    if not 0 <= slot < GRAVEYARD_SLOTS:
        raise ValueError(f"graveyard slot must be 0..{GRAVEYARD_SLOTS - 1}, not {slot}")
    return GRAVEYARD_STRIPS[slot // SLOTS_PER_STRIP]


def graveyard_slot_to_mm(slot):
    """Where to park a captured piece, in machine mm.

    `slot` is 0..31 around the ring (see the diagram above). Every slot sits
    on a board file or rank centre line, so the printed sticker's graveyard
    dots line up with the board's own columns and rows.

    There is no colour argument: all 32 slots are a single shared pool, and
    choosing between them is policy rather than geometry -- see
    graveyard.nearest_free_slot(). This only says where slot n is.

    Mirrors square_to_mm(), and carries the same caveat: the result is in
    board space. If the board is seated rotated (ORIGIN_SQUARE other than h1),
    orient() only rotates file/rank indices, which a graveyard slot does not
    have -- it sits outside the 8x8. So on a rotated rig, mirror the result
    about the board centre rather than reaching for orient().
    """
    strip = graveyard_strip(slot)
    i = slot % SLOTS_PER_STRIP
    if strip == SOUTH:                      # a-file end to h-file end
        return (A1_X_MM + i * SQUARE_MM, GRAVEYARD_Y_LOW_MM)
    if strip == EAST:                       # rank 1 up to rank 8
        return (GRAVEYARD_X_HIGH_MM, A1_Y_MM + i * SQUARE_MM)
    if strip == NORTH:                      # h-file end back to a-file end
        return (A1_X_MM + (7 - i) * SQUARE_MM, GRAVEYARD_Y_HIGH_MM)
    return (GRAVEYARD_X_LOW_MM, A1_Y_MM + (7 - i) * SQUARE_MM)   # WEST, top down


def bury_waypoints(file_, rank, x_mm, y_mm):
    """Every machine-mm point BURY drives through, from the captured piece's
    square to its slot. Mirrors doBury() in the firmware, so the host can
    check a path it never drives itself.

    Like a knight weave, it never crosses a square centre: half a square onto
    the gridline beside its own file (or rank), along that gridline to the
    board's edge line, along the edge line to the slot's file (or rank), then
    out into the slot. Board space in, machine space out -- apply orient_mm to
    the slot and orient() to the square first on a rotated rig, as the planner
    does.
    """
    fs = (x_mm - A1_X_MM) / SQUARE_MM
    rs = (y_mm - A1_Y_MM) / SQUARE_MM
    across_ranks = rs < -0.5 or rs > 7.5
    across_files = fs < -0.5 or fs > 7.5
    if across_ranks == across_files:
        raise ValueError(f"({x_mm}, {y_mm}) is not a graveyard slot")

    def step_toward(target, here):
        if target != here:
            return 0.5 if target > here else -0.5
        return 0.5 if here < 7 else -0.5

    if across_ranks:
        edge = -0.5 if rs < 0 else 7.5
        hx = step_toward(fs, file_)
        board_points = [(file_, rank), (file_ + hx, rank), (file_ + hx, edge), (fs, edge)]
    else:
        edge = -0.5 if fs < 0 else 7.5
        hy = step_toward(rs, rank)
        board_points = [(file_, rank), (file_, rank + hy), (edge, rank + hy), (edge, rs)]
    return [square_to_mm(f, r) for f, r in board_points] + [(x_mm, y_mm)]


def castle_waypoints(file_from, rank, file_to):
    """Every machine-mm point CASTLE drives through: the rook's square, half
    a square OUT past the back rank, along that lane, and back in. Mirrors
    doCastle() in the firmware. Board space in, machine space out.

    Outward is below rank 1 and above rank 8 -- the lane between the board
    and the graveyard strip, 25mm from both. Only a back rank can castle.
    """
    if rank not in (0, 7):
        raise ValueError(f"castling runs along rank 1 or 8, not rank {rank + 1}")
    out = -0.5 if rank == 0 else 7.5
    points = [(file_from, rank), (file_from, out), (file_to, out), (file_to, rank)]
    return [square_to_mm(f, r) for f, r in points]
