TheRealNightmare/PlayerKoi/src/tracking_loop.py

"""Event-gated board tracking loop.

Drives this flow: motion-gate (cheap, ML-free) -> a full 64-square
empty/white/black classification, sampled with multi-frame consensus (see
square_classifier.py) -> compute the observed delta against the tracker's
own state -> match it against every legal chess move (see
move_resolver.MoveResolver.resolve_from_deltas) -> accept, or flag for
manual correction via the web UI.

There is deliberately no automatic rescan fallback in this design. Since
vision only ever needs to answer empty/white/black per square (piece type
comes from the tracker's own maintained state -- see move_resolver.py's
docstring for why), a full-board read every settle is affordable, and both
the classifier and the delta match refuse to guess rather than produce a
wrong answer (see square_classifier.py's consensus/confidence handling).
When something can't be resolved with confidence, the loop leaves state
untouched and flags it; a human corrects it via the web UI
(apply_manual_correction), which is the sole recovery path.

This mirrors the product's own designed flow ("Board Settles -> Image
Captured -> Occupancy/Color Read -> Move Validated -> flag for manual
correction if no legal move matches"), and exploits the guaranteed-correct
starting position: the tracker seeds from the known standard position and
thereafter only needs to resolve *changes*, never re-deriving piece type
from vision.
"""

import threading
import time

from board_state import FILES
from move_resolver import MoveResolver, matrix_from_board, standard_starting_matrix
from roi_diff import MAX_PLAUSIBLE_SQUARES, BoardMotionGate, to_gray_roi
from square_classifier import UNRESOLVED, read_settled_state
from square_geometry import board_roi_bbox, square_pixel_bboxes


# How many squares may come back UNRESOLVED before the whole settle is
# treated as untrustworthy. A handful of marginal squares is normal and
# harmless -- they're skipped when computing the delta, so they can only
# cause a *missed* change, never a wrong one (a move touches >= 2 squares,
# and an incomplete delta matches no legal move, so it flags anyway). Many
# unresolved squares at once means something systematic is wrong (model
# degraded, lighting changed, board moved), which is worth surfacing.
MAX_UNRESOLVED_SQUARES = 8

# A pause (see set_paused) lapses on its own unless something keeps
# refreshing it. The web UI pauses tracking while its board editor is open
# and refreshes this on every poll; if the browser tab closes mid-edit,
# nothing refreshes it and tracking resumes rather than staying silently
# dead with no indication anywhere.
PAUSE_LAPSE_S = 10.0


def _square_name(square):
    file_idx, rank_idx = square
    return f"{FILES[file_idx]}{rank_idx + 1}"


def _describe(squares, limit=6):
    names = sorted(_square_name(square) for square in squares)
    shown = ", ".join(names[:limit])
    return shown if len(names) <= limit else f"{shown}, +{len(names) - limit} more"


def _matrix_color(matrix, square):
    file_idx, rank_idx = square
    label = matrix[rank_idx][file_idx]
    if label is None:
        return "empty"
    return label.split("-")[0]


class TrackingLoop:
    def __init__(
        self,
        capture_stream,
        calibration_matrix,
        image_size,
        classifier_model,
        on_update,
        poll_interval=0.12,
        consensus_samples=3,
        consensus_window_s=0.4,
        classifier_imgsz=64,
        classifier_min_conf=0.7,
        motion_thresh=None,
    ):
        """on_update(matrix, move_text, frame, flagged, reason) is called
        whenever the stable board state changes. move_text is a SAN move
        string (e.g. "Nf3") when the change resolved to a single legal
        move. When the settle couldn't be resolved with confidence,
        move_text is None, flagged is True, and reason is a short
        human-readable explanation -- the board is left untouched until a
        manual correction arrives via apply_manual_correction()."""
        self._capture_stream = capture_stream
        self._calibration_matrix = calibration_matrix
        self._classifier_model = classifier_model
        self._on_update = on_update
        self._poll_interval = poll_interval
        self._consensus_samples = consensus_samples
        self._consensus_window_s = consensus_window_s
        self._classifier_imgsz = classifier_imgsz
        self._classifier_min_conf = classifier_min_conf

        self._roi_bbox = board_roi_bbox(calibration_matrix, image_size)
        self._square_bboxes = square_pixel_bboxes(calibration_matrix, image_size)
        # motion_thresh=None keeps BoardMotionGate's own tuned default --
        # see its docstring for why this needs re-tuning per rig.
        self._gate = BoardMotionGate() if motion_thresh is None else BoardMotionGate(motion_thresh=motion_thresh)
        self._resolver = MoveResolver()
        # Reentrant: current_matrix (used internally by _handle_settle,
        # apply_manual_correction, etc. while already holding the lock) and
        # external callers both go through the same property.
        self._lock = threading.RLock()

        self._stable_matrix = standard_starting_matrix()
        self._stable_frame = None
        self._flag_reason = None
        self._pause_expires_at = 0.0
        self._expected_move = None

    @property
    def board_copy(self):
        """A snapshot of the resolver's position, for callers (the engine)
        that need to reason about it without touching internals."""
        with self._lock:
            return self._resolver.board.copy()

    @property
    def expected_move(self):
        with self._lock:
            return self._expected_move

    def set_expected_move(self, move):
        """Constrains the next accepted settle to exactly `move` (an engine
        has dictated it). Anything else physically played is rejected and
        flagged rather than applied. None lifts the constraint."""
        with self._lock:
            self._expected_move = move

    @property
    def is_paused(self):
        with self._lock:
            return time.monotonic() < self._pause_expires_at

    def set_paused(self, paused, lapse_s=PAUSE_LAPSE_S):
        """Pauses/resumes applying settles. A pause lapses after lapse_s
        unless refreshed by calling this again -- see PAUSE_LAPSE_S."""
        with self._lock:
            self._pause_expires_at = time.monotonic() + lapse_s if paused else 0.0

    @property
    def current_matrix(self):
        with self._lock:
            return [row[:] for row in self._stable_matrix]

    @property
    def turn(self):
        with self._lock:
            return self._resolver.turn

    def reset(self):
        """Re-seeds tracking at the standard starting position and resets
        the move resolver. Wire this to a 'New Game' control."""
        with self._lock:
            self._resolver.reset()
            self._stable_matrix = standard_starting_matrix()
            self._stable_frame = None
            self._flag_reason = None

    def apply_manual_correction(self, matrix, turn, frame):
        """Accepts a user-corrected board state from the web UI -- the sole
        recovery path when a settle can't be resolved with confidence.
        matrix is a full 8x8 type+color matrix (board_state convention),
        turn is "white" or "black"."""
        with self._lock:
            self._resolver.resync(matrix, turn=turn)
            self._stable_matrix = [row[:] for row in matrix]
            self._stable_frame = frame
            self._flag_reason = None
            self._expected_move = None  # position changed; the engine must re-think
            self._on_update(self.current_matrix, None, frame, False, None)

    def set_position(self, board, frame=None):
        """Adopts `board` as the tracked position, exactly as given.

        Puzzle mode's entry point: the position comes from a FEN, and the
        camera has already confirmed the physical board matches it (see
        read_board), so unlike apply_manual_correction nothing needs to be
        inferred -- castling rights and en passant survive intact.
        """
        with self._lock:
            self._resolver.set_board(board)
            self._stable_matrix = matrix_from_board(self._resolver.board)
            if frame is not None:
                self._stable_frame = frame
            self._flag_reason = None
            self._expected_move = None
            self._on_update(self.current_matrix, None, frame, False, None)

    def read_board(self):
        """A full 64-square read right now, with no motion gate and no move
        matching: {(file_idx, rank_idx): "empty"|"white"|"black"|UNRESOLVED}.

        For checking a position someone has just set up by hand -- the same
        multi-frame consensus a settle uses, so a square that won't read
        cleanly comes back UNRESOLVED rather than guessed. Returns None when
        the camera has no frame yet. Changes no state.
        """
        with self._lock:
            frame, _timestamp = self._capture_stream.get_latest()
            if frame is None:
                return None
            return read_settled_state(
                self._classifier_model,
                self._capture_stream,
                self._square_bboxes,
                initial_frame=frame,
                num_samples=self._consensus_samples,
                window_s=self._consensus_window_s,
                imgsz=self._classifier_imgsz,
                min_conf=self._classifier_min_conf,
            )

    def undo_last_move(self, frame=None):
        """Reverts the last accepted move, restoring both the tracked
        matrix and the resolver's board exactly (unlike a manual
        correction, which has to re-infer castling rights). Returns the
        SAN of the undone move, or None when there's nothing to undo --
        including right after a manual correction, since resync() starts a
        fresh board with no history."""
        with self._lock:
            if not self._resolver.board.move_stack:
                return None

            move = self._resolver.board.pop()
            # Legal again now that the position is the one before it, which
            # is what san() needs to describe it.
            san = self._resolver.board.san(move)

            self._stable_matrix = matrix_from_board(self._resolver.board)
            self._flag_reason = None
            self._expected_move = None  # position changed; the engine must re-think
            self._on_update(self.current_matrix, None, frame, False, None)
            return san

    def force_settle(self, frame=None):
        """Runs a full settle read right now, without waiting for the motion
        gate to fire.

        This exists for the robot arm. tick() keeps pumping the gate while
        paused (so its reference frame stays current -- see the comment
        there), which means the gantry's own motion-then-quiet is consumed
        *during* the pause and dropped. Unpausing afterwards leaves a board
        that is already static, so the gate would never fire again and the
        robot's move would never be verified. Calling this once the gantry
        reports done removes the race entirely.

        Returns True if the read resolved to a move, False if it flagged or
        found nothing changed.
        """
        with self._lock:
            if frame is None:
                frame, _timestamp = self._capture_stream.get_latest()
            if frame is None:
                return False
            before = self._resolver.board.move_stack[:]
            self._handle_settle(frame)
            return self._resolver.board.move_stack[:] != before

    def run_forever(self):
        while True:
            self.tick()
            time.sleep(self._poll_interval)

    def tick(self):
        """Runs one cheap motion-gate poll. Only does real work (a full
        occupancy/color read plus legal-move matching) when the gate
        reports "settled" -- most calls just check the ROI's grayscale
        diff and return immediately."""
        frame, _timestamp = self._capture_stream.get_latest()
        if frame is None:
            return

        with self._lock:
            if self._stable_frame is None:
                self._stable_frame = frame

            # Keep pumping the gate even while paused, so its reference
            # frame stays current -- otherwise resuming would diff against
            # a stale frame and fire a bogus settle immediately.
            roi_gray = to_gray_roi(frame, self._roi_bbox)
            settled = self._gate.update(roi_gray) == "settled"

            if time.monotonic() < self._pause_expires_at:
                return
            if not settled:
                return

            self._handle_settle(frame)

    def _handle_settle(self, frame):
        """Called with self._lock held."""
        consensus = read_settled_state(
            self._classifier_model,
            self._capture_stream,
            self._square_bboxes,
            initial_frame=frame,
            num_samples=self._consensus_samples,
            window_s=self._consensus_window_s,
            imgsz=self._classifier_imgsz,
            min_conf=self._classifier_min_conf,
        )

        unresolved = [square for square, state in consensus.items() if state is UNRESOLVED]
        if len(unresolved) > MAX_UNRESOLVED_SQUARES:
            self._flag_unresolved(
                frame,
                f"{len(unresolved)} squares had low-confidence reads ({_describe(unresolved)}) "
                "-- check lighting, or re-check the classifier with debug_classifier.py",
            )
            return

        # Unresolved squares are skipped rather than blocking: they carry no
        # information, so the tracker keeps its prior belief about them. A
        # real move touches at least two squares, and resolve_from_deltas
        # only accepts a delta matching exactly one legal move -- so if the
        # moved square itself is unresolved, the delta comes out incomplete
        # and flags below rather than resolving to something wrong.
        observed_deltas = {
            square: state
            for square, state in consensus.items()
            if state is not UNRESOLVED and state != _matrix_color(self._stable_matrix, square)
        }

        if not observed_deltas:
            # Spurious settle trigger (nothing actually changed) -- refresh
            # the stable frame so the motion gate doesn't keep re-firing on
            # stale pixel drift, but this isn't a real update.
            self._stable_frame = frame
            return

        if len(observed_deltas) > MAX_PLAUSIBLE_SQUARES:
            self._flag_unresolved(
                frame,
                f"{len(observed_deltas)} squares changed at once ({_describe(observed_deltas)}) "
                "-- more than any legal move touches",
            )
            return

        san, _move, patch = self._resolver.resolve_from_deltas(
            observed_deltas, only_move=self._expected_move
        )
        if san is None:
            if self._expected_move is not None:
                reason = (
                    f"expected the engine's move {self._expected_move.uci()}, "
                    f"but saw a change on {_describe(observed_deltas)}"
                )
            else:
                reason = f"no unique legal move explains the change on {_describe(observed_deltas)}"
            self._flag_unresolved(frame, reason)
            return

        for (file_idx, rank_idx), label in patch.items():
            self._stable_matrix[rank_idx][file_idx] = label

        self._stable_frame = frame
        self._flag_reason = None
        self._expected_move = None  # satisfied
        self._on_update(self.current_matrix, san, frame, False, None)

    def _flag_unresolved(self, frame, reason):
        """Called with self._lock held. Leaves _stable_matrix and the
        resolver's board untouched -- last trusted state -- until a manual
        correction arrives. Refreshes _stable_frame so the motion gate
        doesn't keep re-triggering on the same static discrepancy."""
        self._stable_frame = frame
        self._flag_reason = reason
        self._on_update(self.current_matrix, None, frame, True, reason)
