TheRealNightmare/PlayerKoi/src/engine.py

"""Stockfish opponent, and the physical instructions for playing its moves.

The engine plays Black. It reads the live position straight off
MoveResolver's internal chess.Board (see TrackingLoop.board_copy), so
there's no separate game state to keep in sync.

describe_move() is the part that matters at the board: a bare "e8 g8"
isn't enough to actually play a move by hand, because castling also moves
a rook, en passant removes a pawn that isn't on the destination square,
and promotion needs a different piece put down. Every one of those gets
spelled out.
"""

import chess

SKILL_MIN = 0
SKILL_MAX = 20
DEFAULT_SKILL = 3
DEFAULT_THINK_S = 0.5

_PIECE_WORDS = {
    chess.PAWN: "pawn",
    chess.KNIGHT: "knight",
    chess.BISHOP: "bishop",
    chess.ROOK: "rook",
    chess.QUEEN: "queen",
    chess.KING: "king",
}


def describe_move(board, move):
    """Physical instructions for playing `move` in `board` (the position
    *before* the move). Returns (headline, extra) -- headline is the
    from/to to show large, extra is any additional physical action, or
    None. Pure python-chess; no engine needed."""
    origin = chess.square_name(move.from_square)
    target = chess.square_name(move.to_square)
    headline = f"{origin} → {target}"
    mover = board.piece_at(move.from_square)
    color_word = "white" if mover is not None and mover.color == chess.WHITE else "black"

    if board.is_castling(move):
        # The rook's squares aren't in the move at all, so they have to be
        # named explicitly or the position ends up wrong.
        kingside = chess.square_file(move.to_square) > chess.square_file(move.from_square)
        rank = chess.square_rank(move.from_square)
        rook_from = chess.square_name(chess.square(7 if kingside else 0, rank))
        rook_to = chess.square_name(chess.square(5 if kingside else 3, rank))
        side = "kingside" if kingside else "queenside"
        return headline, f"castling {side} — ALSO move the rook {rook_from} → {rook_to}"

    if board.is_en_passant(move):
        # The captured pawn sits beside the destination, not on it.
        captured = chess.square(chess.square_file(move.to_square), chess.square_rank(move.from_square))
        return headline, f"en passant — ALSO remove the pawn on {chess.square_name(captured)}"

    extras = []
    victim = board.piece_at(move.to_square)
    if victim is not None:
        victim_color = "white" if victim.color == chess.WHITE else "black"
        extras.append(f"capture — remove the {victim_color} {_PIECE_WORDS[victim.piece_type]} on {target} first")
    if move.promotion is not None:
        extras.append(f"promotion — replace it with a {color_word} {_PIECE_WORDS[move.promotion]}")

    return headline, "; ".join(extras) if extras else None


class ChessEngine:
    """Stockfish over UCI. Never raises on a missing binary -- `available`
    goes False instead, so the web UI keeps working as a plain tracker."""

    def __init__(self, command="stockfish", skill=DEFAULT_SKILL):
        self._engine = None
        self.error = None
        self._skill = skill
        try:
            import chess.engine

            self._engine = chess.engine.SimpleEngine.popen_uci(command)
        except Exception as exc:  # binary missing, not executable, bad UCI handshake
            self.error = f"{command} not available ({exc.__class__.__name__}) -- try: sudo apt install stockfish"
            return
        self.set_skill(skill)

    @property
    def available(self):
        return self._engine is not None

    @property
    def skill(self):
        return self._skill

    def set_skill(self, skill):
        self._skill = max(SKILL_MIN, min(SKILL_MAX, int(skill)))
        if self._engine is not None:
            try:
                self._engine.configure({"Skill Level": self._skill})
            except Exception:
                pass  # some builds name it differently; strength just stays default

    def best_move(self, board, think_s=DEFAULT_THINK_S, root_moves=None):
        """Returns a chess.Move, or None if unavailable or the position has
        no legal moves (checkmate/stalemate).

        `root_moves` restricts the search to those moves. Note that play()
        -- unlike analyse() -- honours Skill Level, so a restricted play()
        still blunders at whatever strength was configured. That difference
        is the whole reason move_policy.py makes two calls instead of one.
        """
        if self._engine is None or board.is_game_over():
            return None
        import chess.engine

        result = self._engine.play(
            board, chess.engine.Limit(time=think_s), root_moves=root_moves
        )
        return result.move

    def top_moves(self, board, think_s=DEFAULT_THINK_S, count=5, root_moves=None):
        """The engine's `count` best moves, strongest first.

        This is analyse(), so it ignores Skill Level and answers with the
        objectively good moves -- which is what a "reasonable candidates"
        shortlist wants. Returns [] rather than raising if the engine is
        missing or the build doesn't do MultiPV.
        """
        if self._engine is None or board.is_game_over():
            return []
        import chess.engine

        try:
            infos = self._engine.analyse(
                board, chess.engine.Limit(time=think_s),
                multipv=count, root_moves=root_moves,
            )
        except Exception:
            return []  # no MultiPV, or the search was cut short
        if isinstance(infos, dict):  # multipv=1 can come back unwrapped
            infos = [infos]
        return [info["pv"][0] for info in infos if info.get("pv")]

    def analyse(self, board, think_s=DEFAULT_THINK_S):
        """Full-strength evaluation of `board`, for the coach.

        Returns {"score_cp", "mate", "pv"} from White's point of view --
        exactly one of score_cp/mate is set -- or None if the engine is
        missing, the position is over, or the search failed. Like
        top_moves() this is analyse(), so Skill Level does not weaken it:
        the opponent can play at 3 while the advice stays honest.
        """
        if self._engine is None or board.is_game_over():
            return None
        import chess.engine

        try:
            info = self._engine.analyse(board, chess.engine.Limit(time=think_s))
        except Exception:
            return None
        score = info.get("score")
        if score is None:
            return None
        white = score.white()
        return {
            "score_cp": None if white.is_mate() else white.score(),
            "mate": white.mate() if white.is_mate() else None,
            "pv": list(info.get("pv") or []),
        }

    def close(self):
        if self._engine is not None:
            try:
                self._engine.quit()
            except Exception:
                pass
            self._engine = None
