TheRealNightmare/PlayerKoi/(commit log)

2026-08-10 Initial commit: MicroChess board detection with YOLO26l ChessReD model
2026-08-10 Add live web UI: clean 8x8 board diagram from tracked board state
2026-08-10 Add live camera feed and move descriptions to the web UI
2026-08-13 efficient 1
    [model.ncnn.param]
2026-08-14 progress 2
    [model.ncnn.param]
2026-09-21 new board updates
    [ChessBot_V2_board.dxf, ChessBot_V2_board.step]
2026-09-29 puzzle and coatch feature
    [puzzles.csv]
2026-10-01 trash file removed
    [ChessBot_V2_board.dxf, ChessBot_V2_board.step]
